GasGenSol/Particle-Electron-Carrier/Electron Carrier System Diagram.graffle/image1.png

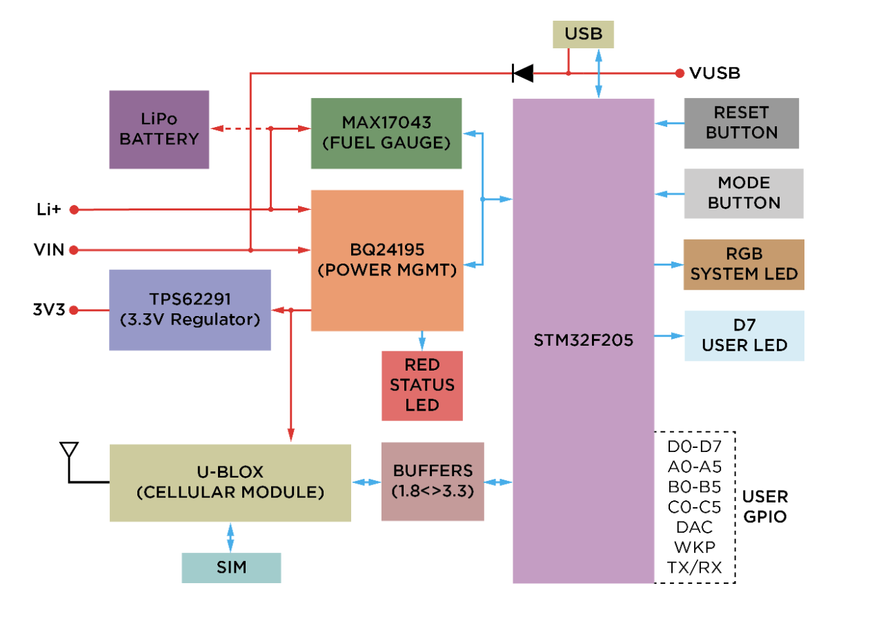
Electron Carrier System Diagram.graffle/image1.png
