GasGenSol/Particle-Electron-Carrier/Carrier Board.brd

## EAGLE design Carrier Board.brd (2018-06-30)

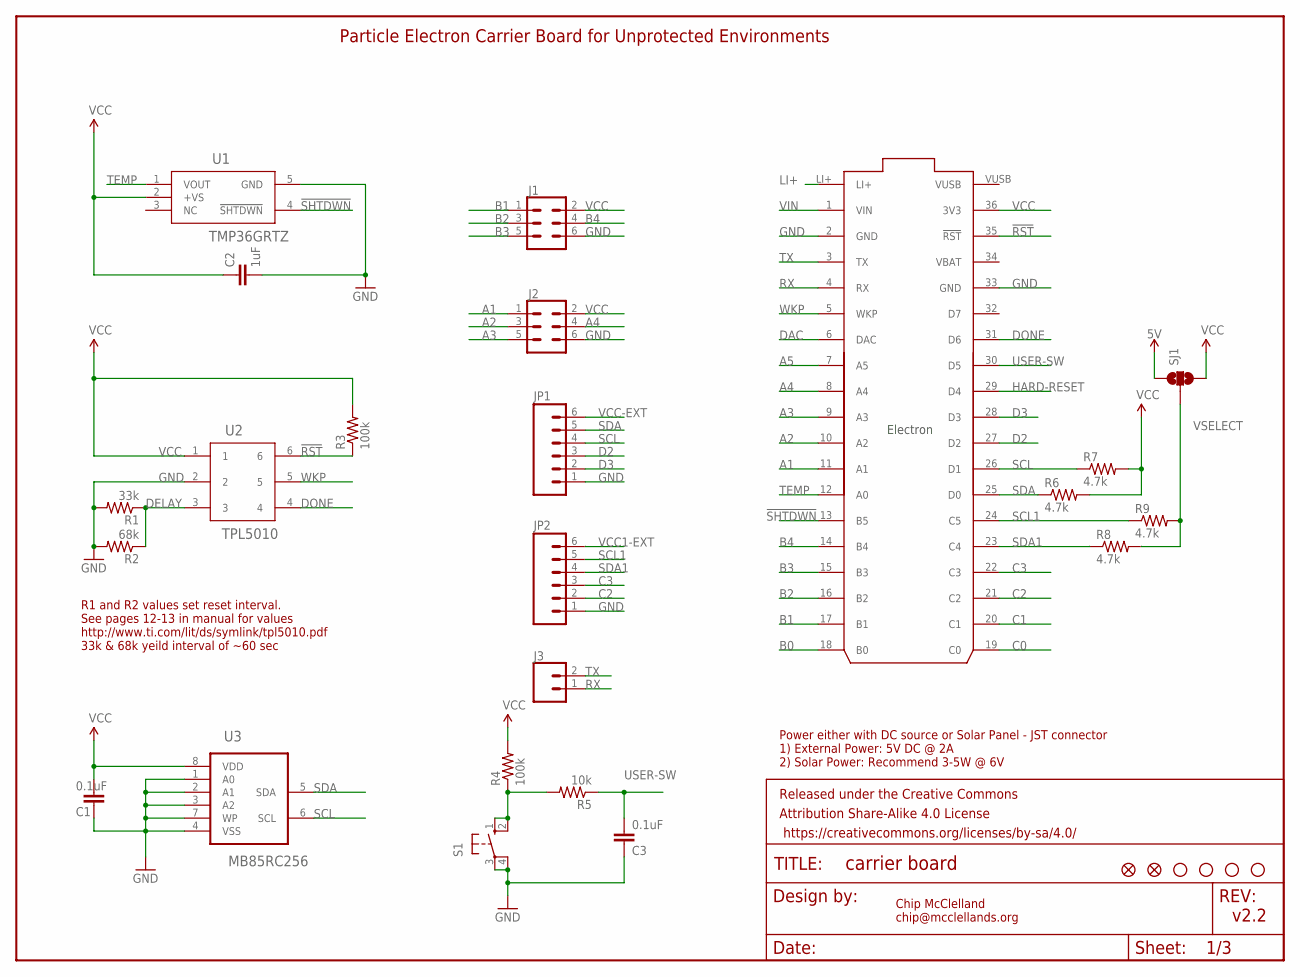
[picture p2: schematic Carrier Board.sch, sheet 1, Sensors]

Parts:
C1, C3: 0.1uF; 0805
C2: 1uF; 0805
FD1, FD2: FIDUCIALUFIDUCIAL; FIDUCIAL-MICRO
FRAME1: FRAME-LETTER; CREATIVE_COMMONS
J1, J2: CONN_03X22X3_SILK_MALE_PTH; 2X3
J3: CONN_02; 1X02
JP1, JP2: M06LOCK; 1X06_LOCK
JP3, JP4, JP5, JP6: STAND-OFF
R1: 33k; 0805
R2: 68k; 0805
R3, R4: 100k; 0805
R5: 10k; 0805
R6, R7, R8, R9: 4.7k; 0805
S1: 10-XX; B3F-10XX
SJ1: SOLDERJUMPER_2WAYPASTE1&2; SJ_3_PASTE1&2
U1: TMP36GRTZ; RJ_5
U2: TPL5010; TSOT-23
U3: MB85RC256; SOIC127P600X175-8N
U4: Particle Electron; ELECTON-PWR-PINS

Connections:
5V: SJ1.1; also elsewhere on the board
!RST: R3.1, U2.6, U4.35 (!RST)
!SHTDWN: U1.4 (!SHTDWN), U4.13 (B5)
A1: J2.1, U4.11 (A1)
A2: J2.3, U4.10 (A2)
A3: J2.5, U4.9 (A3)
A4: J2.4, U4.8 (A4)
A5: U4.7 (A5)
B0: U4.18 (B0)
B1: J1.1, U4.17 (B1)
B2: J1.3, U4.16 (B2)
B3: J1.5, U4.15 (B3)
B4: J1.4, U4.14 (B4)
C0: U4.19 (C0)
C1: U4.20 (C1)
C2: JP2.2, U4.21 (C2); also elsewhere on the board
C3: JP2.3, U4.22 (C3); also elsewhere on the board
D2: JP1.3, U4.27 (D2); also elsewhere on the board
D3: JP1.2, U4.28 (D3); also elsewhere on the board
DAC: U4.6 (DAC)
DELAY: R1.1, R2.1, U2.3
DONE: U2.4, U4.31 (D6)
GND: C1.2, C2.2, C3.2, J1.6, J2.6, JP1.1, JP2.1, R1.2, R2.2, S1.3, S1.4 (P1), U1.5 (GND), U2.2, U3.1 (A0), U3.2 (A1), U3.3 (A2), U3.4 (VSS), U3.7 (WP), U4.2 (GND), U4.33 (GND); also elsewhere on the board
HARD-RESET: U4.29 (D4); also elsewhere on the board
LI+: U4.LI+; also elsewhere on the board
unnamed: R4.1, R5.2, S1.1 (S), S1.2 (S1)
RX: J3.1, U4.4 (RX)
SCL: JP1.4, R7.1, U3.6 (SCL), U4.26 (D1); also elsewhere on the board
SCL1: JP2.5, R9.1, U4.24 (C5); also elsewhere on the board
SDA: JP1.5, R6.1, U3.5 (SDA), U4.25 (D0); also elsewhere on the board
SDA1: JP2.4, R8.1, U4.23 (C4); also elsewhere on the board
TEMP: U1.1 (VOUT), U4.12 (A0)
TX: J3.2, U4.3 (TX)
USER-SW: C3.1, R5.1, U4.30 (D5)
VBAT: U4.34 (VBAT)
VCC: C1.1, C2.1, J1.2, J2.2, R3.2, R4.2, R6.2, R7.2, SJ1.3, U1.2 (+VS), U2.1, U3.8 (VDD), U4.36 (3V3); also elsewhere on the board
VCC1-EXT: JP2.6; also elsewhere on the board
VCC-EXT: JP1.6; also elsewhere on the board
VIN: U4.1 (VIN); also elsewhere on the board
VSELECT: R8.2, R9.2, SJ1.2; also elsewhere on the board
WKP: U2.5, U4.5 (WKP)

Notes on the sheet:
Chip McClelland chip@mcclellands.org
v2.2
Power either with DC source or Solar Panel - JST connector 1) External Power: 5V DC @ 2A 2) Solar Power: Recommend 3-5W @ 6V
Particle Electron Carrier Board for Unprotected Environments
R1 and R2 values set reset interval. See pages 12-13 in manual for values http://www.ti.com/lit/ds/symlink/tpl5010.pdf 33k & 68k yeild interval of ~60 sec

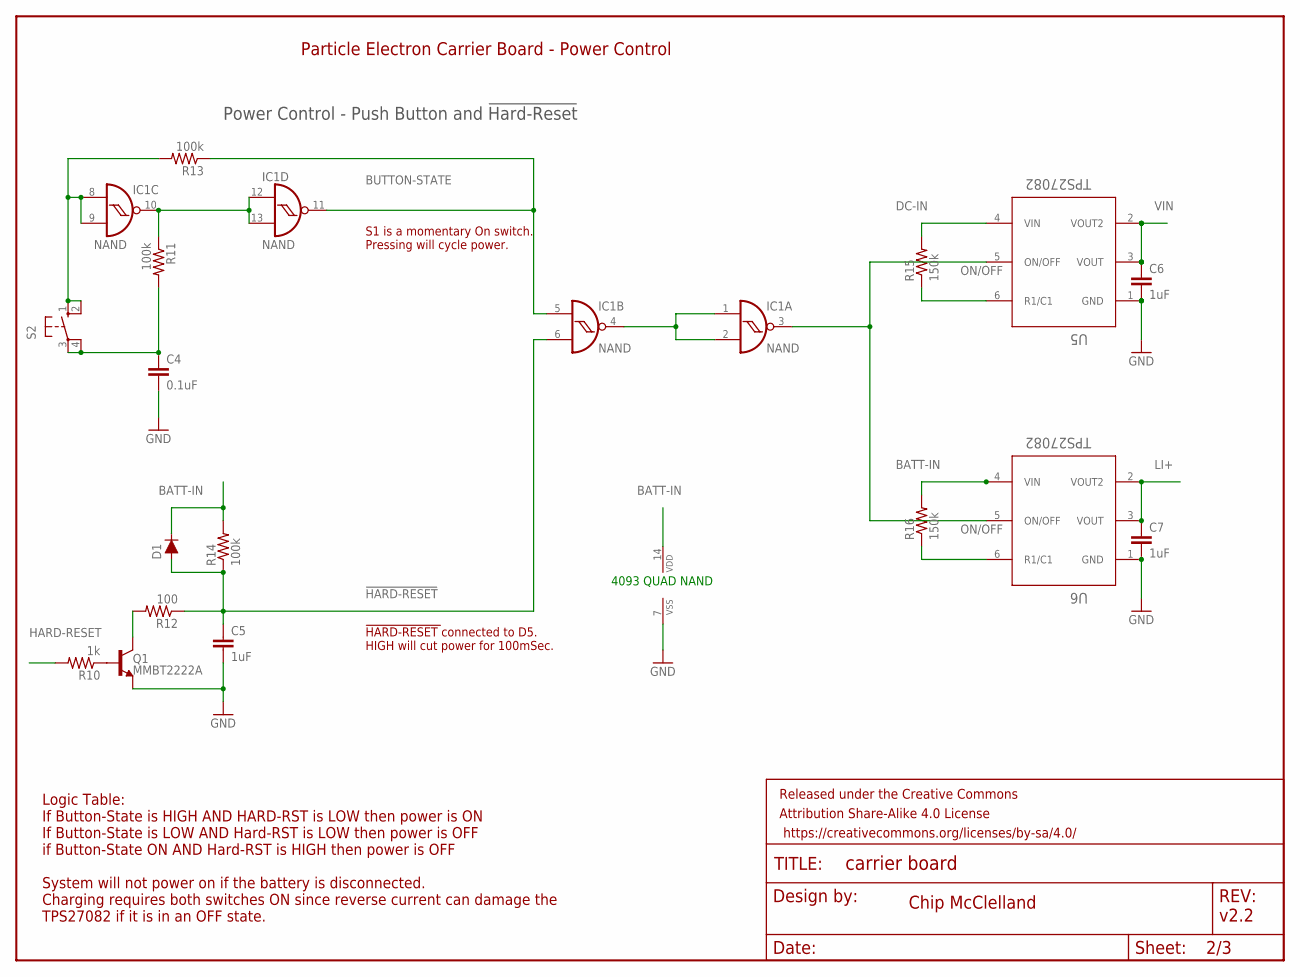
[picture p3: schematic Carrier Board.sch, sheet 2, Power Control]

Parts:
C4: 0.1uF; 0805
C5, C6, C7: 1uF; 0805
D1: DIODE-BAS16J; SOD-323
FRAME2: FRAME-LETTER; CREATIVE_COMMONS
IC1: NAND; MC14093B-TSSOP14
Q1: MMBT2222A; SOT23-3
R10: 1k; 0805
R11, R13, R14: 100k; 0805
R12: 100; 0805
R15, R16: 150k; 0805
S2: 40-XX-ROUND; B3F-40XX-ROUND
U5, U6: TPS27082; TSOT-23

Connections:
!HARD-RESET: C5.1, D1.A, IC1.6 (I1), R12.1, R14.1
BATT-IN: D1.C, IC1.14 (VDD), R14.2, R16.2, U6.4 (VIN); also elsewhere on the board
BUTTON-STATE: IC1.5 (I0), IC1.11 (O), R13.1
DC-IN: R15.2, U5.4 (VIN); also elsewhere on the board
GND: C4.2, C5.2, C6.2, C7.2, IC1.7 (VSS), Q1.2 (E), U5.1 (GND), U6.1 (GND); also elsewhere on the board
HARD-RESET: R10.2; also elsewhere on the board
LI+: C7.1, U6.2 (VOUT2), U6.3 (VOUT); also elsewhere on the board
unnamed: IC1.1 (I0), IC1.2 (I1), IC1.4 (O)
unnamed: IC1.10 (O), IC1.12 (I0), IC1.13 (I1), R11.1
unnamed: R15.1, U5.6 (R1/C1)
unnamed: Q1.1 (B), R10.1
unnamed: R16.1, U6.6 (R1/C1)
unnamed: Q1.3 (C), R12.2
unnamed: C4.1, R11.2, S2.3, S2.4 (P1)
unnamed: IC1.8 (I0), IC1.9 (I1), R13.2, S2.1 (S), S2.2 (S1)
ON/OFF: IC1.3 (O), U5.5 (ON/OFF), U6.5 (ON/OFF)
VIN: C6.1, U5.2 (VOUT2), U5.3 (VOUT); also elsewhere on the board

Notes on the sheet:
Particle Electron Carrier Board - Power Control
4093 QUAD NAND
Power Control - Push Button and !Hard-Reset
Chip McClelland
v2.2
Logic Table: If Button-State is HIGH AND HARD-RST is LOW then power is ON If Button-State is LOW AND Hard-RST is LOW then power is OFF if Button-State ON AND Hard-RST is HIGH then power is OFF System will not power on if the battery is disconnected. Charging requires both switches ON since reverse 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
!HARD-RESET !connected to D5. HIGH will cut power for 100mSec.
S1 is a momentary On switch. Pressing will cycle power.

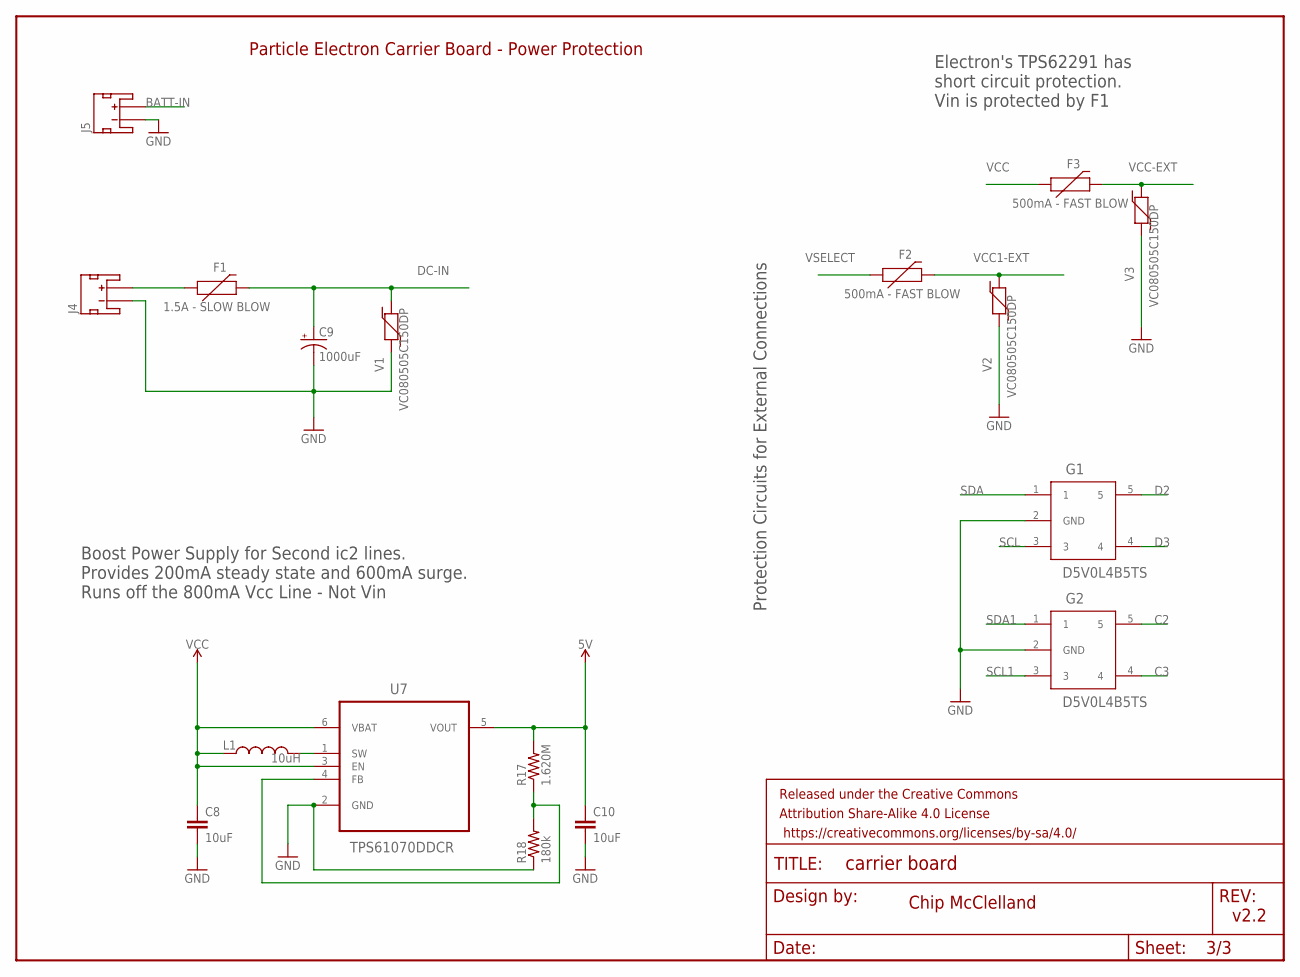
[picture p4: schematic Carrier Board.sch, sheet 3, Protection and 5V Boost]

Parts:
C8, C10: 10uF; 0805
C9: 1000uF; PANASONIC_G
F1: 1.5A - SLOW BLOW; 1206
F2, F3: 500mA - FAST BLOW; 1206
FRAME3: FRAME-LETTER; CREATIVE_COMMONS
G1, G2: D5V0L4B5TS; SOT-23-5
J4: 5V @ 2A; JST-2-SMD
J5: JST_2MM_MALE; JST-2-SMD
L1: 10uH; SDR0403
R17: 1.620M; 0805
R18: 180k; 0805
U7: TPS61070DDCR; SOT95P280X110-6N
V1, V2, V3: VC080505C150DP; 0805

Connections:
5V: C10.1, R17.2, U7.5 (VOUT); also elsewhere on the board
BATT-IN: J5.2 (+); also elsewhere on the board
C2: G2.5; also elsewhere on the board
C3: G2.4; also elsewhere on the board
D2: G1.5; also elsewhere on the board
D3: G1.4; also elsewhere on the board
DC-IN: C9.+, F1.2, V1.2; also elsewhere on the board
DC-IN-EXT: F1.1, J4.2 (+)
GND: C8.2, C9.-, C10.2, G1.2 (GND), G2.2 (GND), J4.1 (-), J5.1 (-), R18.1, U7.2 (GND), V1.1, V2.1, V3.1; also elsewhere on the board
unnamed: R17.1, R18.2, U7.4 (FB)
SCL: G1.3; also elsewhere on the board
SCL1: G2.3; also elsewhere on the board
SDA: G1.1; also elsewhere on the board
SDA1: G2.1; also elsewhere on the board
SW: L1.P$2 (2), U7.1 (SW)
VCC: C8.1, F3.1, L1.P$1 (1), U7.3 (EN), U7.6 (VBAT); also elsewhere on the board
VCC1-EXT: F2.2, V2.2; also elsewhere on the board
VCC-EXT: F3.2, V3.2; also elsewhere on the board
VSELECT: F2.1; also elsewhere on the board

Notes on the sheet:
Protection Circuits for External Connections
Electron's TPS62291 has short circuit protection. Vin is protected by F1
Boost Power Supply for Second ic2 lines. Provides 200mA steady state and 600mA surge. Runs off the 800mA Vcc Line - Not Vin
Chip McClelland
v2.2
Particle Electron Carrier Board - Power Protection

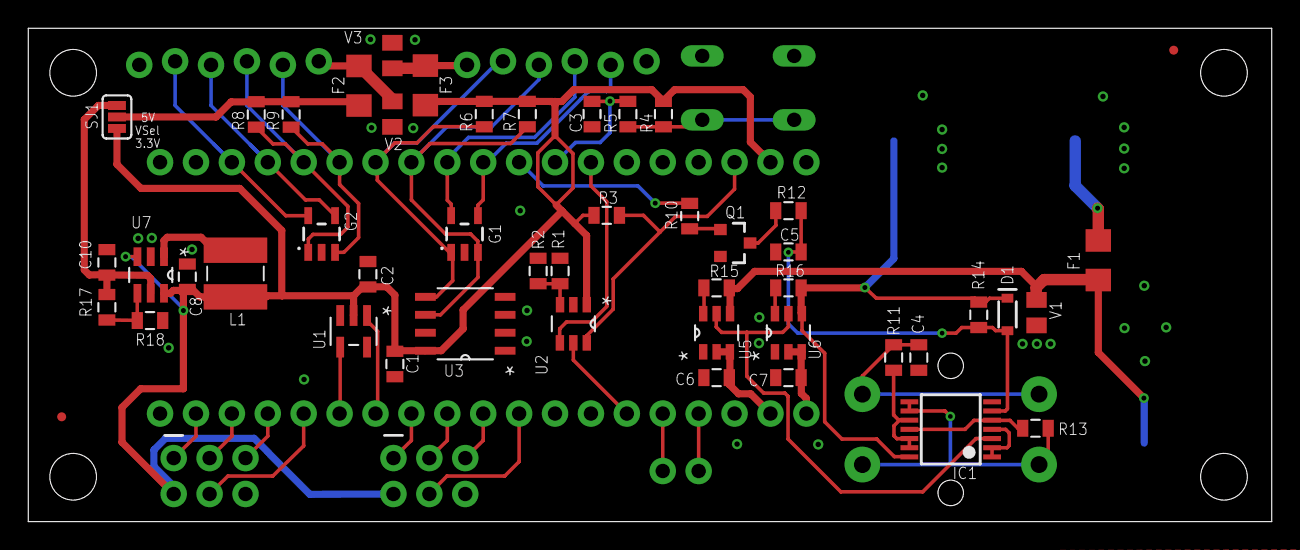
[picture p5: board Carrier Board.brd from above]

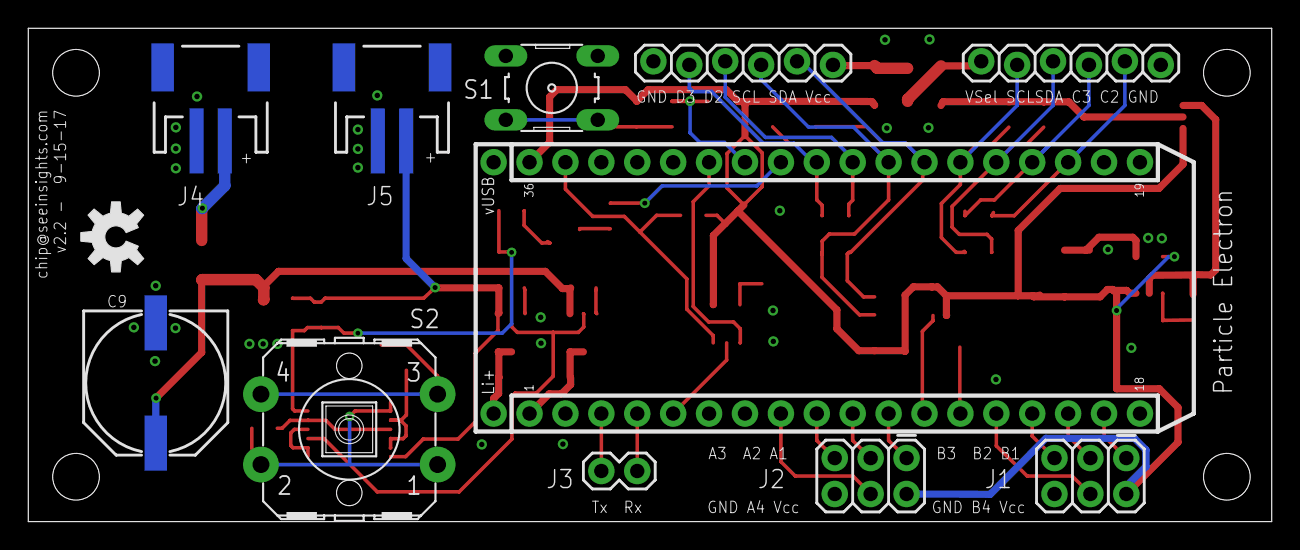
[picture p6: board Carrier Board.brd from below]

Board: 2 copper layers, 88.0 x 34.9 mm, 67 parts (12 on the bottom side), 51 nets.

Other parts of the board:
U$2: OSHW-LOGO-M
