GasGenSol/Particle-Electron-Carrier/(commit log)

2017-09-15 Particle Electron Carrier v2.2
    This is the first version I feel good enough to release. Tested and
    refined over the past three months in the woods of North Carolina.
    [Carrier Board.brd, Carrier Board.sch]
2017-09-18 Added BOM File
    Added Digikey BOM
    [Carrier Board BOM.csv]
2018-06-30 Added Carrier Library
    [Carrier Board.brd, Carrier Board.sch]
